freeDSP/freeDSP-SPDIFTransceiver/PCB_Render/SPDIF_Transceiver_Bottom.png

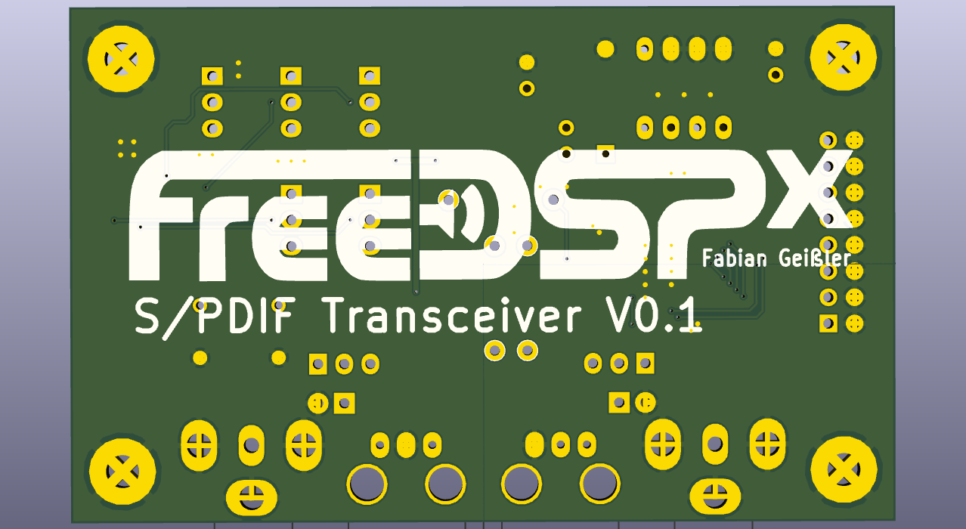
PCB_Render/SPDIF_Transceiver_Bottom.png
