freeDSP/freeDSP-SPDIFTransceiver/PCB_Render/SPDIF_Transceiver_Top.png

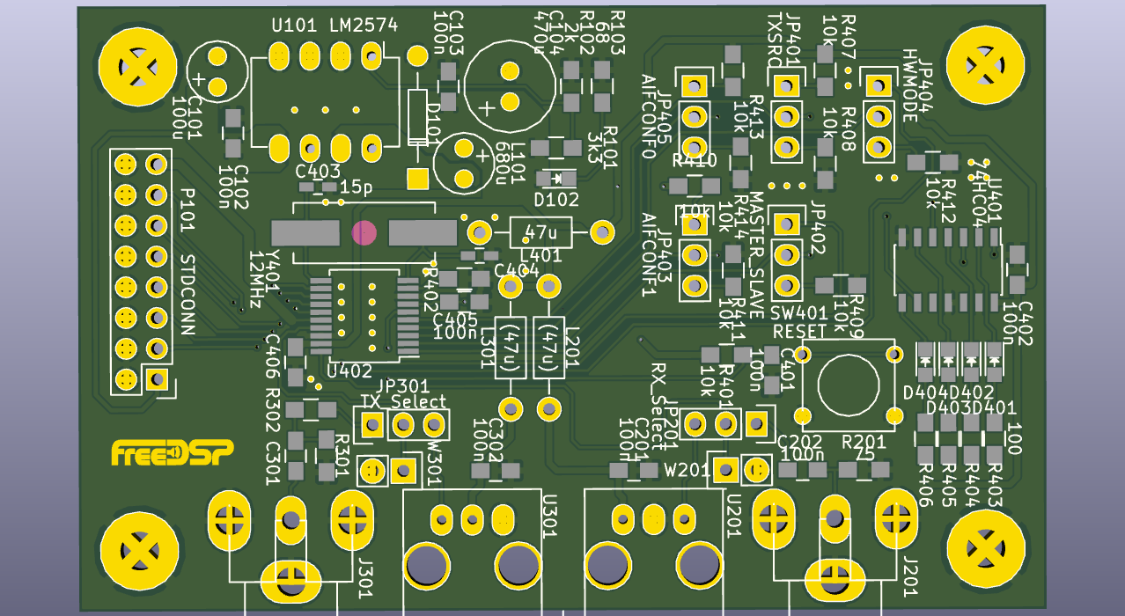
PCB_Render/SPDIF_Transceiver_Top.png
