freeDSP/freeDSP-SPDIFTransceiver/BOM.pdf

Reference | Value | Footprint | Einkauf
C101 | 100u | Elko 11x5mm RM2,5 | Reichelt/DigiKey/Mouser
C102 | 100n | 0805 | Reichelt/DigiKey/Mouser
C103 | 100n | 0805 | Reichelt/DigiKey/Mouser
C104 | 470u | Elko 20x10mm RM5 | Reichelt/DigiKey/Mouser
C201 | 100n | 0805 | Reichelt/DigiKey/Mouser
C202 | 100n | 0805 | Reichelt/DigiKey/Mouser
C301 | 100n | 0805 | Reichelt/DigiKey/Mouser
C302 | 100n | 0805 | Reichelt/DigiKey/Mouser
C401 | 100n | 0805 | Reichelt/DigiKey/Mouser
C402 | 100n | 0805 | Reichelt/DigiKey/Mouser
C403 | 15p | 0603 | Reichelt/DigiKey/Mouser
C404 | 15p | 0603 | Reichelt/DigiKey/Mouser
C405 | 100n | 0805 | Reichelt/DigiKey/Mouser
C406 | 100n | 0805 | Reichelt/DigiKey/Mouser
D101 | D_Schottky | RM10 | Reichelt/DigiKey/Mouser
D102 | Green | 0805 | Reichelt/DigiKey/Mouser
D401 | Yellow | 0805 | Reichelt/DigiKey/Mouser
D402 | Yellow | 0805 | Reichelt/DigiKey/Mouser
D403 | Yellow | 0805 | Reichelt/DigiKey/Mouser
D404 | Yellow | 0805 | Reichelt/DigiKey/Mouser
J201 | SPDIF_IN | RCA RM2,5 | DigiKey/Mouser
J301 | SPDIF_OUT | RCA RM2,5 | DigiKey/Mouser
JP201 | RX_Select | 1x3 RM2,54 | Reichelt/DigiKey/Mouser
JP301 | TX_Select | 1x3 RM2,54 | Reichelt/DigiKey/Mouser
JP401 | TXSRC | 1x3 RM2,54 | Reichelt/DigiKey/Mouser
JP402 | MASTER_SLAVE | 1x3 RM2,54 | Reichelt/DigiKey/Mouser
JP403 | AIFCONF1 | 1x3 RM2,54 | Reichelt/DigiKey/Mouser
JP404 | HWMODE | 1x3 RM2,54 | Reichelt/DigiKey/Mouser
JP405 | AIFCONF0 | 1x3 RM2,54 | Reichelt/DigiKey/Mouser
L101 | 680u | Ind. stehend 11x5mm RM2.5 100mA | DigiKey/Mouser
L201 | (47u) | RM10 | /
L301 | (47u) | RM10 | /
L401 | 100u | RM10 | Reichelt/DigiKey/Mouser
P101 | STDCONN | 2x8 RM2,54 Wanne | Reichelt/DigiKey/Mouser
R101 | 3k3 | 0805 | Reichelt/DigiKey/Mouser
R102 | 2k | 0805 | Reichelt/DigiKey/Mouser
R103 | 68 | 0805 | Reichelt/DigiKey/Mouser
R201 | 75 | 0805 | Reichelt/DigiKey/Mouser
R301 | 110 | 0805 | Reichelt/DigiKey/Mouser
R302 | 210 | 0805 | Reichelt/DigiKey/Mouser
R401 | 10k | 0805 | Reichelt/DigiKey/Mouser
R402 | 50 | 0805 | Reichelt/DigiKey/Mouser
R403 | 100 | 0805 | Reichelt/DigiKey/Mouser
R404 | 100 | 0805 | Reichelt/DigiKey/Mouser
R405 | 100 | 0805 | Reichelt/DigiKey/Mouser
R406 | 100 | 0805 | Reichelt/DigiKey/Mouser
R407 | 10k | 0805 | Reichelt/DigiKey/Mouser
R408 | 10k | 0805 | Reichelt/DigiKey/Mouser
R409 | 10k | 0805 | Reichelt/DigiKey/Mouser
R410 | 10k | 0805 | Reichelt/DigiKey/Mouser
R411 | 10k | 0805 | Reichelt/DigiKey/Mouser
R412 | 10k | 0805 | Reichelt/DigiKey/Mouser
R413 | 10k | 0805 | Reichelt/DigiKey/Mouser
R414 | 10k | 0805 | Reichelt/DigiKey/Mouser
SW401 | RESET | Switch RM5 | Reichelt/DigiKey/Mouser
U101 | LM2574 | DIP-8 | Reichelt/DigiKey/Mouser
U201 | TORX147/PLR135 | TOxx147 | DigiKey/Mouser
U301 | TOTX147/PLT133 | TOxx147 | DigiKey/Mouser
U401 | 74HC04 | SOIC-14 3.9x8.7mm Pitch1.27mm | Reichelt/DigiKey/Mouser
U402 | WM8804 | SSOP-20 5.3x7.2mm Pitch0.65mm | DigiKey/Mouser
Y401 | 12MHz | HC49 SMD | Reichelt/DigiKey/Mouser
