freeDSP/freeDSP-SPDIFTransceiver/Gerber/SPDIF_Transceiver-F_Cu.pdf

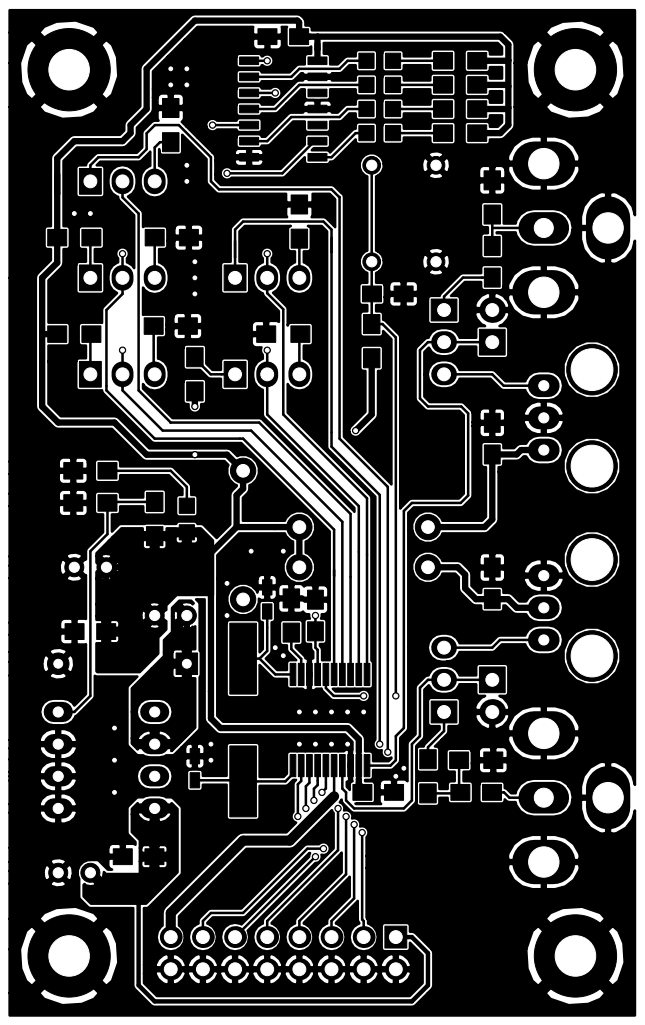
[picture p7: page 1]
