freeDSP/freeDSP-SPDIFTransceiver/SPDIF_Transceiver.kicad_pcb

## KiCad design SPDIF_Transceiver.kicad_pcb (2016-11-18)

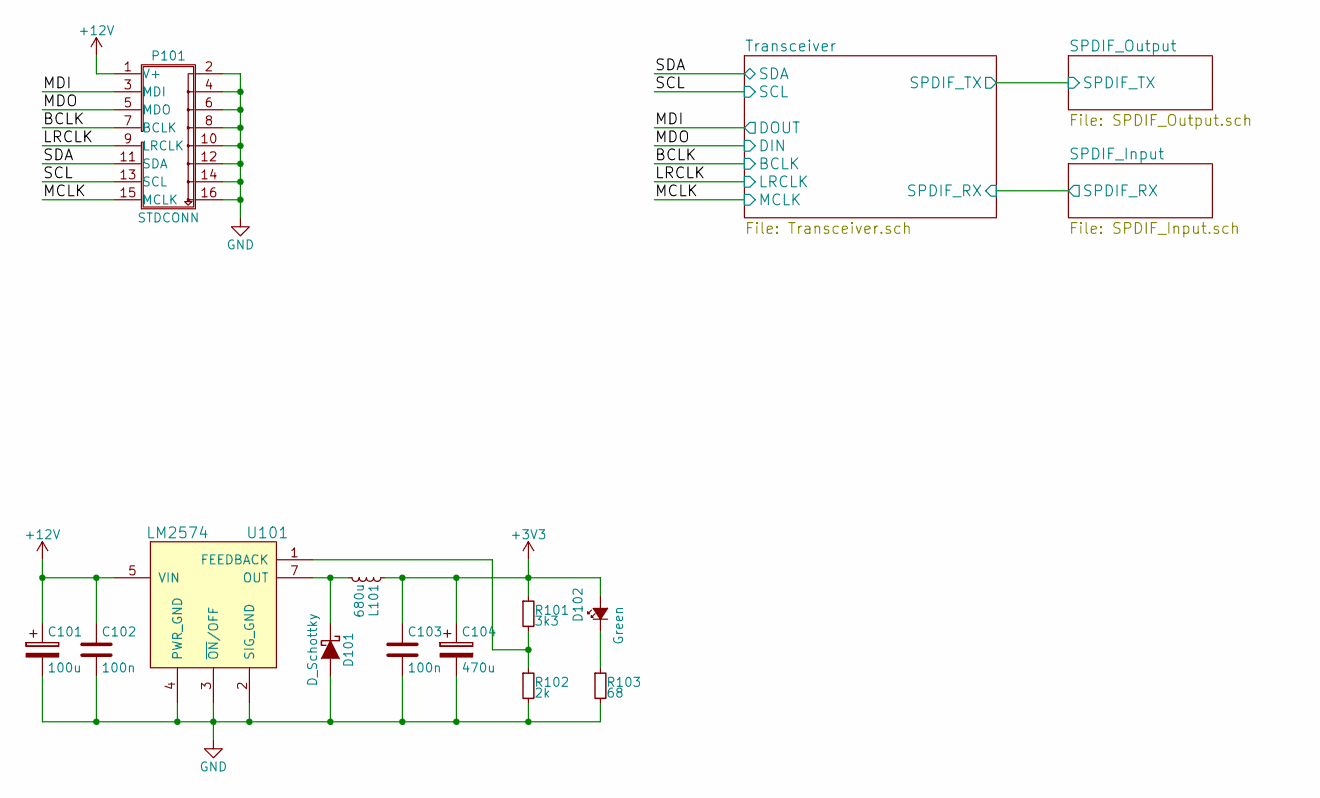
[picture p8: schematic SPDIF_Transceiver.sch]

Parts:
C101: 100u; Elko_vert_11x5mm_RM2.5_CopperClear
C102, C103: 100n; C_0805_HandSoldering
C104: 470u; Elko_vert_20x10mm_RM5_CopperClear
D101: D_Schottky; Diode_DO-35_SOD27_Horizontal_RM10
D102: Green; LED-0805
L101: 680u; Elko_vert_11x5mm_RM2.5_CopperClear
P101: STDCONN; Pin_Header_Straight_2x08
R101: 3k3; R_0805_HandSoldering
R102: 2k; R_0805_HandSoldering
R103: 68; R_0805_HandSoldering
U101: LM2574; DIP-8_W7.62mm_LongPads

Connections:
+3V3: C103.1, C104.1, D102.2 (A), L101.1, R101.1; also elsewhere on the board
+12V: C101.1, C102.1, P101.1 (V+), U101.5 (VIN)
/Transceiver/BCLK: P101.7 (BCLK); also elsewhere on the board
/Transceiver/DIN: P101.5 (MDO); also elsewhere on the board
/Transceiver/DOUT: P101.3 (MDI); also elsewhere on the board
/Transceiver/LRCLK: P101.9 (LRCLK); also elsewhere on the board
/Transceiver/MCLK: P101.15 (MCLK); also elsewhere on the board
/Transceiver/SCL: P101.13 (SCL); also elsewhere on the board
/Transceiver/SDA: P101.11 (SDA); also elsewhere on the board
GND: C101.2, C102.2, C103.2, C104.2, D101.2 (A), P101.2 (GND), P101.4 (GND), P101.6 (GND), P101.8 (GND), P101.10 (GND), P101.12 (GND), P101.14 (GND), P101.16 (GND), R102.2, R103.2, U101.2 (SIG_GND), U101.3 (~ON~/OFF), U101.4 (PWR_GND); also elsewhere on the board
unnamed: D101.1 (K), L101.2, U101.7 (OUT)
unnamed: D102.1 (K), R103.1
unnamed: R101.2, R102.1, U101.1 (FEEDBACK)

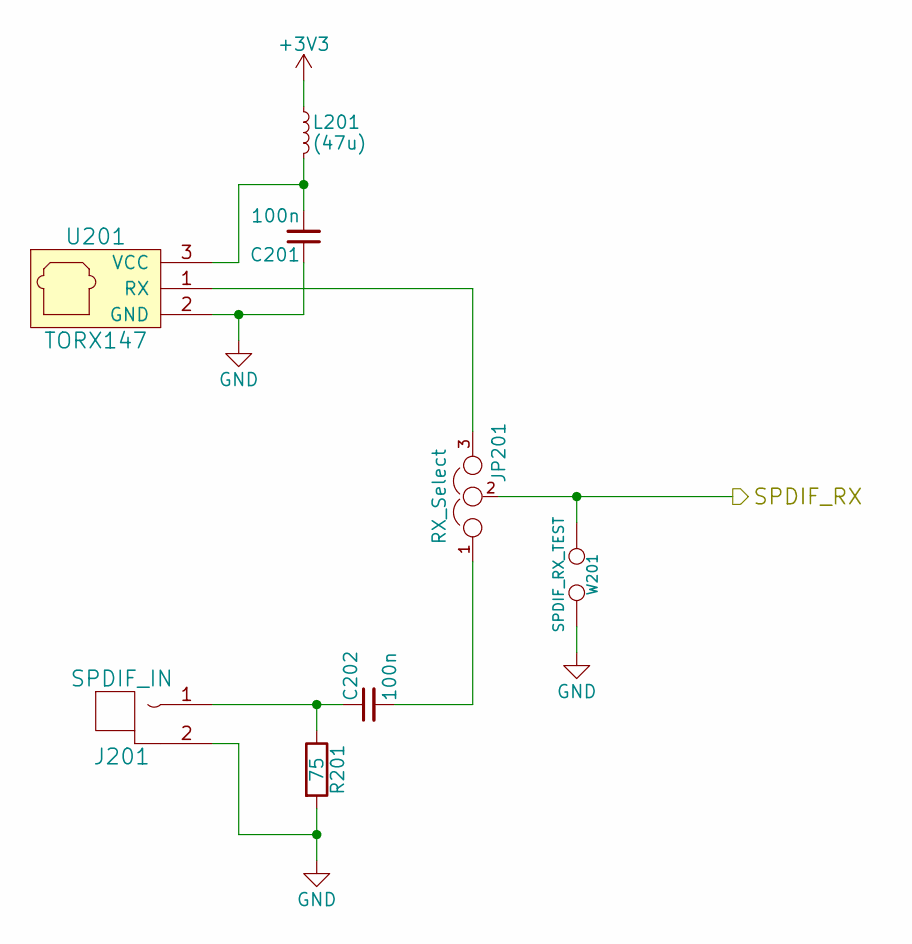
[picture p9: schematic SPDIF_Input.sch]

Parts:
C201, C202: 100n; C_0805_HandSoldering
J201: SPDIF_IN; CB-5
JP201: RX_Select; Pin_Header_Straight_1x03
L201: (47u); Resistor_Horizontal_RM10mm
R201: 75; R_0805_HandSoldering
U201: TORX147; TOxx147
W201: SPDIF_RX_TEST; Pin_Header_Straight_1x02

Connections:
+3V3: L201.1; also elsewhere on the board
/SPDIF_Input/SPDIF_RX: JP201.2, W201.1; also elsewhere on the board
GND: C201.1, J201.2 (GND), R201.2, U201.2 (GND), W201.2; also elsewhere on the board
unnamed: C201.2, L201.2, U201.3 (VCC)
unnamed: C202.1, J201.1 (SIG), R201.1
unnamed: C202.2, JP201.1
unnamed: JP201.3, U201.1 (RX)

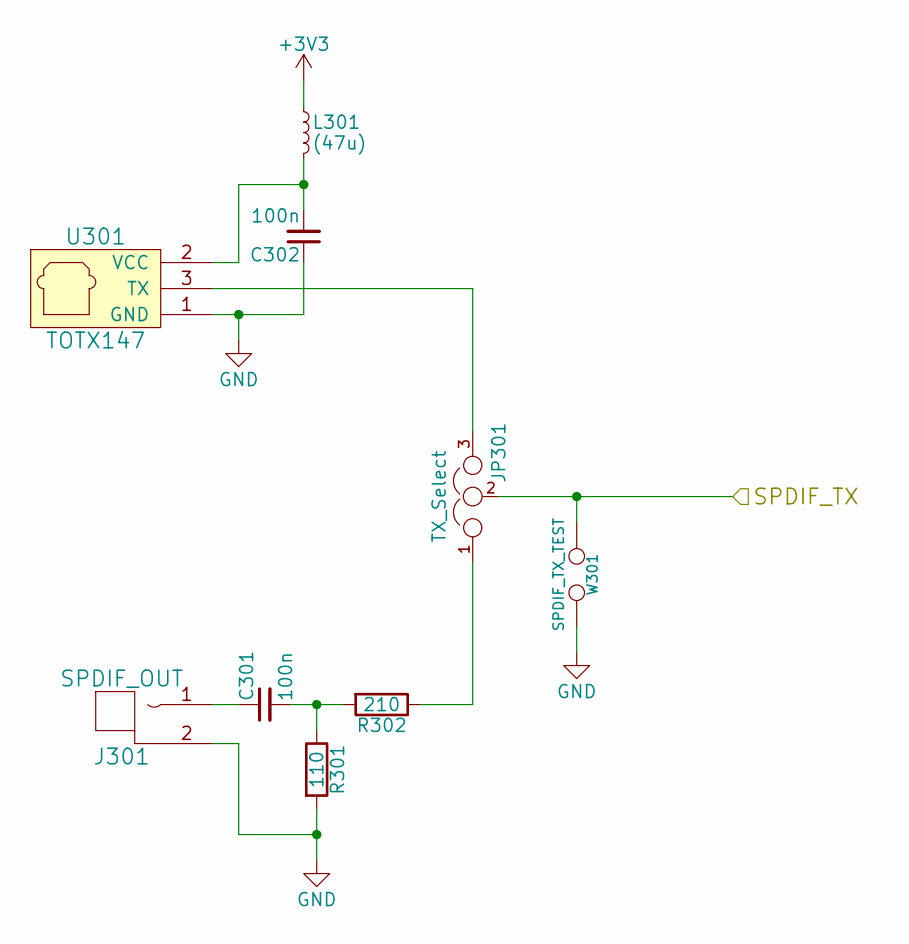
[picture p10: schematic SPDIF_Output.sch]

Parts:
C301, C302: 100n; C_0805_HandSoldering
J301: SPDIF_OUT; CB-5
JP301: TX_Select; Pin_Header_Straight_1x03
L301: (47u); Resistor_Horizontal_RM10mm
R301: 110; R_0805_HandSoldering
R302: 210; R_0805_HandSoldering
U301: TOTX147; TOxx147
W301: SPDIF_TX_TEST; Pin_Header_Straight_1x02

Connections:
+3V3: L301.1; also elsewhere on the board
/SPDIF_Output/SPDIF_TX: JP301.2, W301.1; also elsewhere on the board
GND: C302.1, J301.2 (GND), R301.2, U301.1 (GND), W301.2; also elsewhere on the board
unnamed: C301.1, J301.1 (SIG)
unnamed: C301.2, R301.1, R302.2
unnamed: C302.2, L301.2, U301.2 (VCC)
unnamed: JP301.1, R302.1
unnamed: JP301.3, U301.3 (TX)

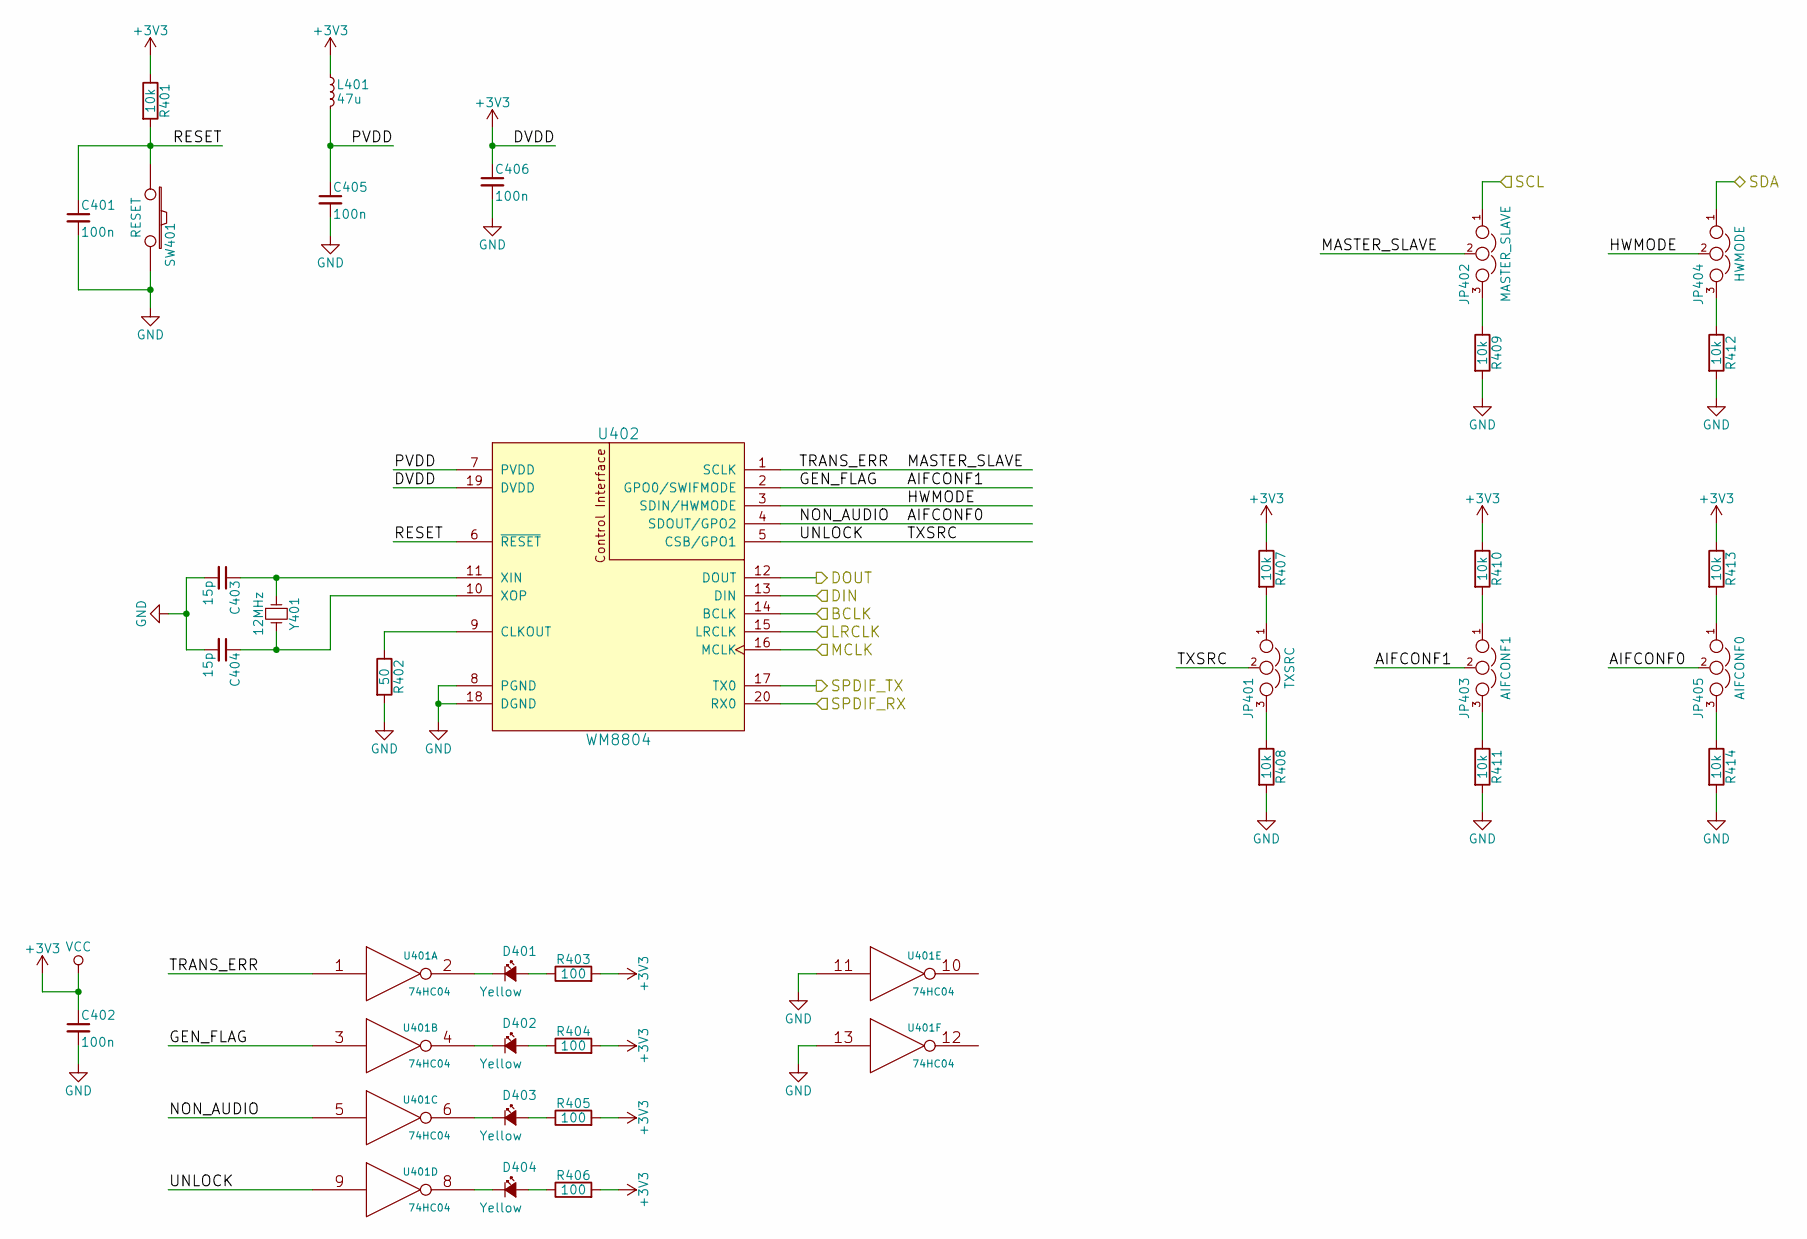
[picture p11: schematic Transceiver.sch]

Parts:
C401, C402, C405, C406: 100n; C_0805_HandSoldering
C403, C404: 15p; C_0603_HandSoldering
D401, D402, D403, D404: Yellow; LED-0805
JP401: TXSRC; Pin_Header_Straight_1x03
JP402: MASTER_SLAVE; Pin_Header_Straight_1x03
JP403: AIFCONF1; Pin_Header_Straight_1x03
JP404: HWMODE; Pin_Header_Straight_1x03
JP405: AIFCONF0; Pin_Header_Straight_1x03
L401: 47u; Resistor_Horizontal_RM10mm
R401, R407, R408, R409, R410, R411, R412, R413, R414: 10k; R_0805_HandSoldering
R402: 50; R_0805_HandSoldering
R403, R404, R405, R406: 100; R_0805_HandSoldering
SW401: RESET; SW_PUSH_SMALL
U401: 74HC04; SOIC-14_3.9x8.7mm_Pitch1.27mm
U402: WM8804; SSOP-20_5.3x7.2mm_Pitch0.65mm
Y401: 12MHz; Crystal_HC49-SD_SMD

Connections:
+3V3: C402.1, C406.1, L401.1, R401.1, R403.2, R404.2, R405.2, R406.2, R407.1, R410.1, R413.1, U401.14 (VCC), U402.19 (DVDD); also elsewhere on the board
/SPDIF_Input/SPDIF_RX: U402.20 (RX0); also elsewhere on the board
/SPDIF_Output/SPDIF_TX: U402.17 (TX0); also elsewhere on the board
/Transceiver/AIFCONF0: JP405.2, U401.5, U402.4 (SDOUT/GPO2)
/Transceiver/AIFCONF1: JP403.2, U401.3, U402.2 (GPO0/SWIFMODE)
/Transceiver/BCLK: U402.14 (BCLK); also elsewhere on the board
/Transceiver/DIN: U402.13 (DIN); also elsewhere on the board
/Transceiver/DOUT: U402.12 (DOUT); also elsewhere on the board
/Transceiver/HWMODE: JP404.2, U402.3 (SDIN/HWMODE)
/Transceiver/LRCLK: U402.15 (LRCLK); also elsewhere on the board
/Transceiver/MASTER_SLAVE: JP402.2, U401.1, U402.1 (SCLK)
/Transceiver/MCLK: U402.16 (MCLK); also elsewhere on the board
/Transceiver/PVDD: C405.1, L401.2, U402.7 (PVDD)
/Transceiver/RESET: C401.1, R401.2, SW401.1, U402.6 (~RESET)
/Transceiver/SCL: JP402.1; also elsewhere on the board
/Transceiver/SDA: JP404.1; also elsewhere on the board
/Transceiver/TXSRC: JP401.2, U401.9, U402.5 (CSB/GPO1)
GND: C401.2, C402.2, C403.2, C404.2, C405.2, C406.2, R402.2, R408.2, R409.2, R411.2, R412.2, R414.2, SW401.2, U401.7 (GND), U401.11, U401.13, U402.8 (PGND), U402.18 (DGND); also elsewhere on the board
unnamed: C403.1, U402.11 (XIN), Y401.1
unnamed: C404.1, U402.10 (XOP), Y401.2
unnamed: D401.1 (K), U401.2
unnamed: D401.2 (A), R403.1
unnamed: D402.1 (K), U401.4
unnamed: D402.2 (A), R404.1
unnamed: D403.1 (K), U401.6
unnamed: D403.2 (A), R405.1
unnamed: D404.1 (K), U401.8
unnamed: D404.2 (A), R406.1
unnamed: JP401.1, R407.2
unnamed: JP401.3, R408.1
unnamed: JP402.3, R409.1
unnamed: JP403.1, R410.2
unnamed: JP403.3, R411.1
unnamed: JP404.3, R412.1
unnamed: JP405.1, R413.2
unnamed: JP405.3, R414.1
unnamed: R402.1, U402.9 (CLKOUT)

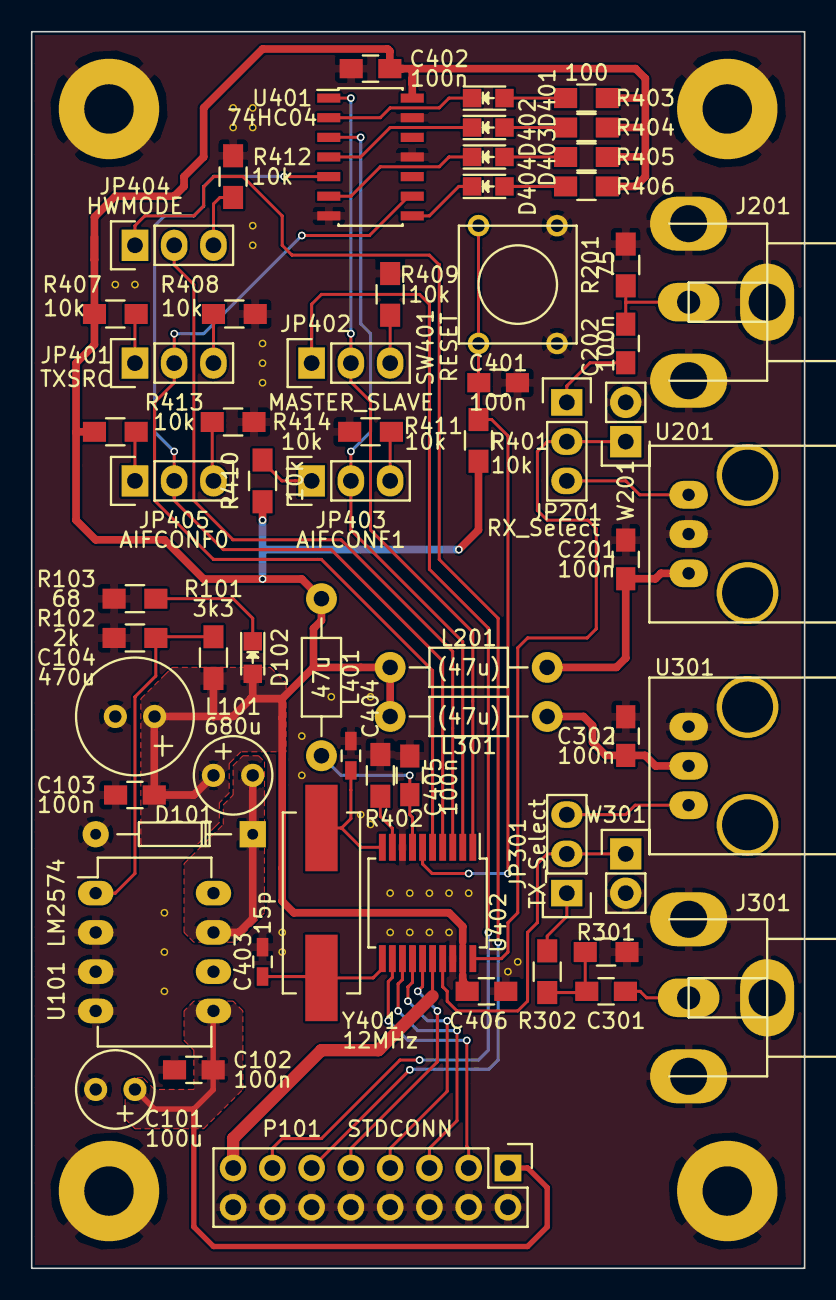
[picture p12: board SPDIF_Transceiver.kicad_pcb from above]

Board: 2 copper layers, 50.0 x 80.0 mm, 63 parts (0 on the bottom side), 50 nets.
