freeDSP/freeDSP-SPDIFTransceiver/(commit log)

2016-05-15 Created Schematic.
    [SPDIF_Input.sch, SPDIF_Output.sch, SPDIF_Transceiver.sch, Transceiver.sch]
2016-05-16 Added board layout.
    [SPDIF_Input.sch, SPDIF_Output.sch, SPDIF_Transceiver.kicad_pcb, Transceiver.sch]
2016-05-16 Little changes, added Gerber Files.
    [SPDIF_Transceiver.kicad_pcb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]
2016-05-30 Added BOM
    [BOM.xls, SPDIF_Transceiver.csv]
2016-11-18 pre update
    [SPDIF_Transceiver.kicad_pcb]
